Hnit3003/Intern_PIFLAB_2023/Solfware/build/bootloader-prefix/src/bootloader-stamp/bootloader-source_dirinfo.txt

# This is a generated file and its contents are an internal implementation detail.
# The download step will be re-executed if anything in this file changes.
# No other meaning or use of this file is supported.

method=source_dir
command=
source_dir=D:/Solfware/ESP_IDF/Espressif/frameworks/esp-idf-v4.4.4/components/bootloader/subproject
work_dir=
