Hnit3003/Intern_PIFLAB_2023/Hardware/Datasheet/Board thực tập hè.xlsx

Board thực tập hè 2023
Số thứ tự | Tên | Số lượng | Giá | Link sản phẩm | Datasheet
1 | Mạch Thu Phát Wifi BLE SoC ESP32 ESP-WROOM-32E | 1 | 95000 | Mạch thu phát Wifi BLE SoC ESP32 ESP-WROOM-32E chính hãng Espressif – Hshop.vn (https://hshop.vn/products/mach-thu-phat-wifi-ble-soc-esp32-v1) | esp32-wroom-32e_esp32-wroom-32ue_datasheet_en.pdf (espressif.com) (https://www.espressif.com/sites/default/files/documentation/esp32-wroom-32e_esp32-wroom-32ue_datasheet_en.pdf) | 95000
10 | LM2596S-5.0 IC Điều Chỉnh Giảm Áp 5V 3A TO-263-5 | 1 | 7900 | LM2596S-5.0 IC Điều Chỉnh Giảm Áp 5V 3A TO-263-5 Điện áp vào: 4.5-40VDC, điện áp ra: 5VDC, 1 ngõ ra (thegioiic.com) (https://www.thegioiic.com/lm2596s-5-0-ic-dieu-chinh-giam-ap-5v-3a-to-263-5) | LM2596 SIMPLE SWITCHER® Power Converter 150-kHz 3-A Step-Down Voltage Regulator datasheet (Rev. G) (ti.com) (https://www.ti.com/lit/ds/symlink/lm2596.pdf) | 7900
11 | CDRH127 Cuộn Cảm Dán SMD 1280-680 68uH 3.2A | 1 | 3200 | CDRH127 Cuộn Cảm Dán SMD 1280-680 68uH 3.2A 20%, size 12 x 12 x 8mm (thegioiic.com) (https://www.thegioiic.com/cdrh127-cuon-cam-dan-smd-1280-680-68uh-3-2a) |  | 3200
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
