Hnit3003/Intern_PIFLAB_2023/Hardware/Intership_board.kicad_pcb

## KiCad design Hardware/Intership_board.kicad_pcb (2023-08-09)

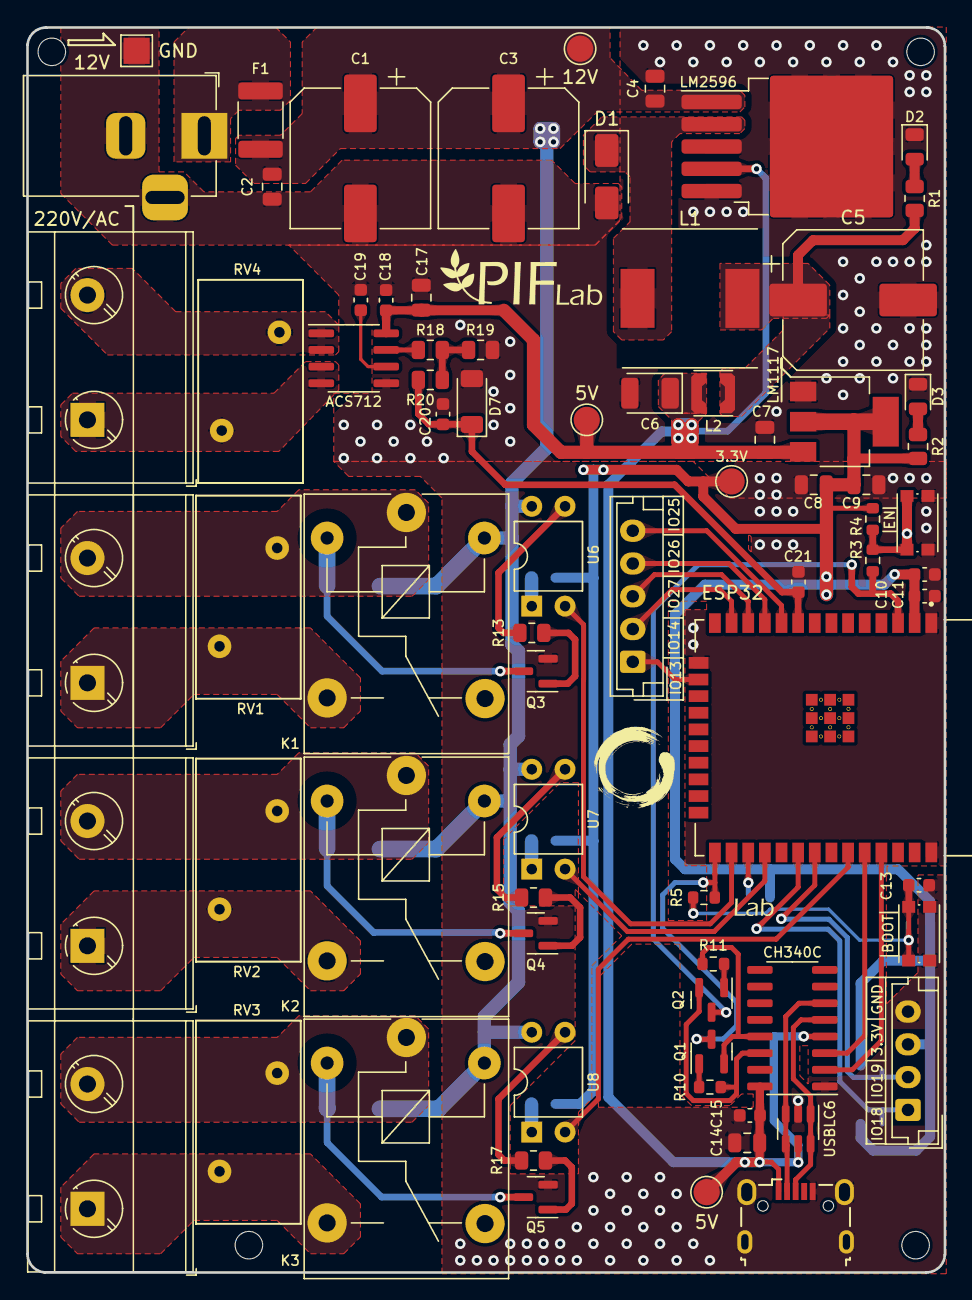
[picture p1: board Intership_board.kicad_pcb from above]

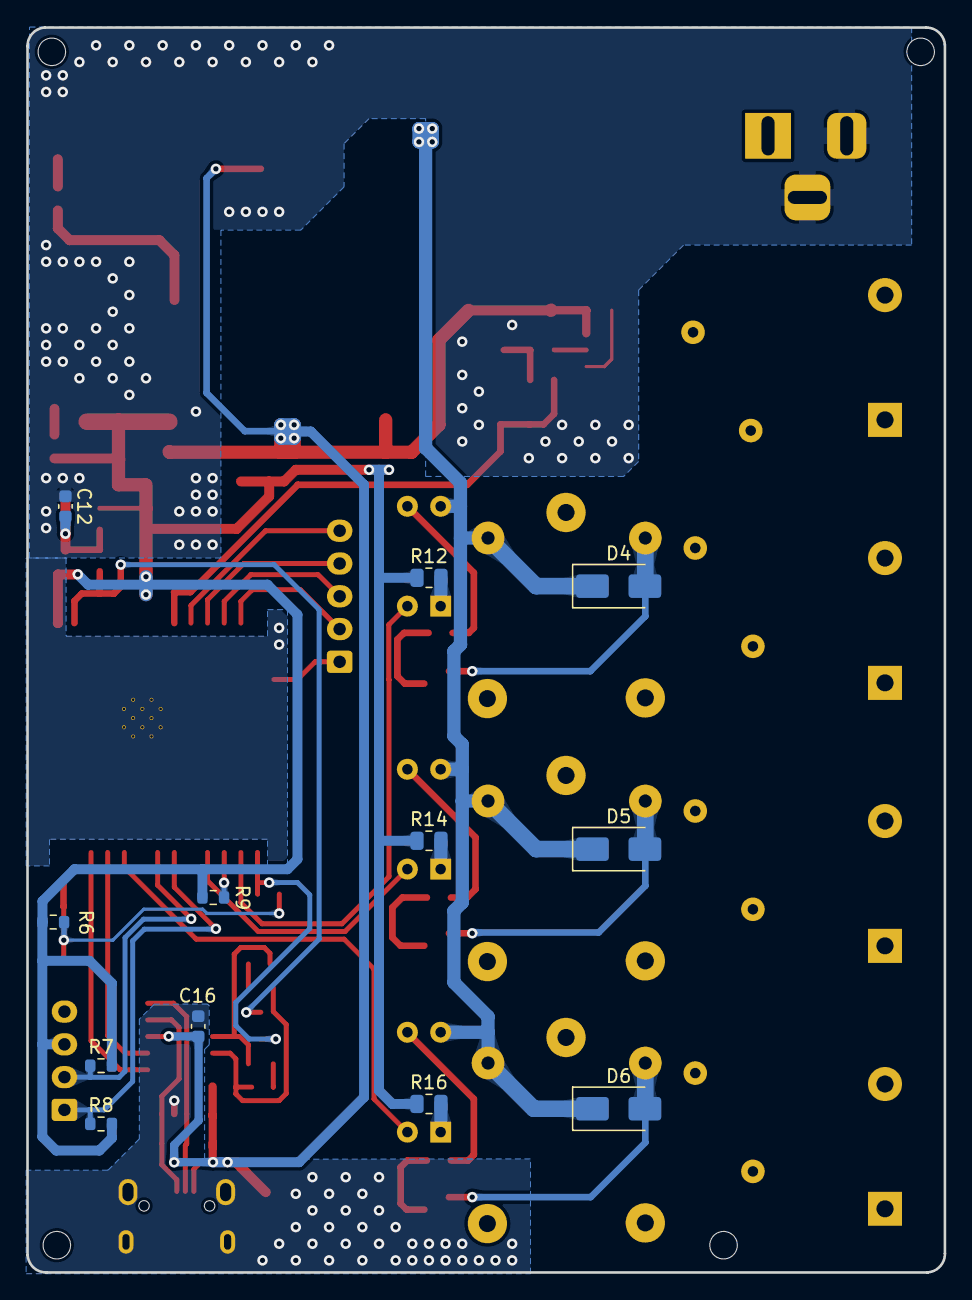
[picture p2: board Intership_board.kicad_pcb from below]

Board: 2 copper layers, 70.0 x 95.0 mm, 91 parts (12 on the bottom side), 56 nets.

Parts:
3.3V: 3.3VDC; TestPoint_Pad_D2.0mm
5V: USB_B_Mini; USB_Micro-B_Wuerth_629105150521
5V#2: VBUS; TestPoint_Pad_D2.0mm
5V#3: 5VDC; TestPoint_Pad_D2.0mm
12V: 12VDC/2~3mA; BarrelJack_Horizontal
12V#2: 12VDC; TestPoint_Pad_D2.0mm
220V/AC: Load 220V/AC; TerminalBlock_MetzConnect_Type703_RT10N02HGLU_1x02_P9.52mm_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
ACS712: ACS712xLCTR-20A; SOIC-8_3.9x4.9mm_P1.27mm
BOOT: SW_Push; SW_Push_1P1T_NO_CK_KMR2
C1, C3: 470uF/35V; CP_Elec_10x10.5
C2, C4: 0.1uF/50V; C_0805_2012Metric
C5: 330uF/35V; CP_Elec_10x10.5
C6: 220uF/16V; CP_EIA-3528-12_Kemet-T
C7, C14: 10uF/25V; C_0805_2012Metric
C8, C17: 22uF/16V; C_0805_2012Metric
C9: 100nF/50V; C_0805_2012Metric
C10: 10uF/25V; C_0603_1608Metric
C11, C12, C13, C15, C16, C18, C19, C21: 100nF/50V; C_0603_1608Metric
C20: 500nF/25V; C_0603_1608Metric
CH340C: CH340C; SOIC-16_3.9x9.9mm_P1.27mm
D1: SS34/3A; D_SMA
D2, D3: LED; LED_0805_2012Metric
D4, D5, D6: SS210/2A/100V; D_SMA
D7: ZMM3V3; D_MiniMELF
EN: SW_Push; SW_Push_1P1T_NO_CK_KMR2
ESP32: ESP32-WROOM-32E; XCVR_ESP32-WROOM-32E
F1: 500mA; Fuse_1812_4532Metric_Pad1.30x3.40mm_HandSolder
GND: Earth; TestPoint_Pad_2.0x2.0mm
H1, H3, H4: Through Hole; MountingHole_2.1mm
H2: Through hole; MountingHole_2.1mm
J2: Conn_01x04_Pin; JST_EH_B4B-EH-A_1x04_P2.50mm_Vertical
J3: Conn_01x05_Pin; JST_EH_B5B-EH-A_1x05_P2.50mm_Vertical
J5, J6, J7: Load 220V/AC; TerminalBlock_MetzConnect_Type703_RT10N02HGLU_1x02_P9.52mm_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
K1, K2, K3: SRD-12VDC-SL-C; Relay_SPDT_SANYOU_SRD_Series_Form_C
L1: 68uH/2.08A; L_Taiyo-Yuden_NR-10050_9.8x10.0mm
L2: 3uH/2.2A; L_Coilcraft_LPS3010
LM1117: LM1117MP-3.3; SOT-223-3_TabPin2
LM2596: LM2596S-ADJ; TO-263-5_TabPin3
Q1, Q2: BC817; SOT-23
Q3, Q4, Q5: MMBTA42/300V/0.5mA; SOT-23
R1, R2, R18, R19: 1k; R_0805_2012Metric
R3, R5: 0; R_0603_1608Metric
R4, R6, R7, R8, R9, R10, R11: 10k; R_0603_1608Metric
R12, R14, R16: 200; R_0805_2012Metric
R13, R15, R17: 2.2k; R_0805_2012Metric
R20: 2.1k; R_0805_2012Metric
RV1, RV2, RV3, RV4: 420L40/680V; RV_Disc_D15.5mm_W8mm_P7.5mm
U6, U7, U8: PC817; DIP-4_W7.62mm
USBLC6: USBLC6-2SC6; SOT-23-6

Connections:
3.3VDC: 3.3V.1, C8.1, C9.1, C10.1, C11.1, ESP32.2 (VDD), J2.3, LM1117.2 (VO), R2.1, R4.2, R6.2, R7.2, R8.2, R9.2, R12.1, R14.1, R16.1
5VDC: 5V.1 (VBUS), 5V#2.1, 5V#3.1, ACS712.8 (VCC), C6.1, C7.1, C14.2, C15.2, C16.1, C17.2, C18.2, CH340C.4 (V3), CH340C.16 (VCC), L2.2, LM1117.3 (VI), LM2596.4 (FB), USBLC6.5 (VBUS)
12VDC: 12V#2.1, C1.1, C2.1, C3.1, C4.1, D4.1 (K), D5.1 (K), D6.1 (K), F1.2, K1.5, K2.5, K3.5, LM2596.1 (VIN), U6.4, U7.4, U8.4
DTR: CH340C.13 (~DTR), Q1.2 (E), R11.1
ESP_EN: ESP32.3 (EN), Q2.3 (C), R3.2
ESP_IO0: ESP32.25 (IO0), Q1.3 (C), R5.1
ESP_IO18: ESP32.30 (IO18), J2.1, R8.1
ESP_IO19: ESP32.31 (IO19), J2.2, R7.1
ESP_IO25: ESP32.10 (IO25), J3.5
ESP_IO26: ESP32.11 (IO26), J3.4
ESP_IO27: ESP32.12 (IO27), J3.3
ESP_IO_ADC2_CH0: C20.2, C21.2, D7.1 (K), ESP32.9 (IO33), R20.2
ESP_IO_Relay_1: ESP32.26 (IO4), U6.2
ESP_IO_Relay_2: ESP32.28 (IO17), U7.2
ESP_IO_Relay_3: ESP32.33 (IO21), U8.2
ESP_MOSI: ESP32.16 (IO13), J3.1
ESP_RXD: CH340C.3 (RXD), ESP32.34 (RXD0/IO3)
ESP_SCLK: ESP32.13 (IO14), J3.2
ESP_TXD: CH340C.2 (TXD), ESP32.35 (TXD0/IO1)
Earth: 5V.5 (GND), 5V.6 (Shield), 12V.2, 12V.3, ACS712.5 (GND), BOOT.2, C1.2, C2.2, C3.2, C4.2, C5.2, C6.2, C7.2, C8.2, C9.2, C10.2, C11.2, C12.1, C13.2, C14.1, C15.1, C16.2, C17.1, C18.1, C19.1, C20.1, C21.1, CH340C.1 (GND), D1.2 (A), D2.1 (K), D3.1 (K), D7.2 (A), EN.1, ESP32.1 (GND), ESP32.15 (GND), ESP32.38 (GND), ESP32.39_10, ESP32.39_11, ESP32.39_12, ESP32.39_13, ESP32.39_14, ESP32.39_15, ESP32.39_16, ESP32.39_17, ESP32.39_18, ESP32.39_19, ESP32.39_20, ESP32.39_21, GND.1, J2.4, LM1117.1 (GND), LM2596.3 (GND), LM2596.5 (~ON/OFF), Q3.2 (E), Q4.2 (E), Q5.2 (E), R19.1, USBLC6.2 (GND)
unnamed: C5.1, L1.2, L2.1, R1.1
unnamed: C12.2, EN.2, R3.1, R4.1
unnamed: BOOT.1, C13.1, R5.2, R6.1
unnamed: D1.1 (K), L1.1, LM2596.2 (OUT)
unnamed: D2.2 (A), R1.2
unnamed: D3.2 (A), R2.2
unnamed: D4.2 (A), K1.2, Q3.3 (C)
unnamed: D5.2 (A), K2.2, Q4.3 (C)
unnamed: D6.2 (A), K3.2, Q5.3 (C)
unnamed: 12V.1, F1.1
unnamed: 5V.3 (D+), CH340C.5 (UD+), USBLC6.1 (I/O1), USBLC6.6 (I/O1)
unnamed: 5V.2 (D-), CH340C.6 (UD-), USBLC6.3 (I/O2), USBLC6.4 (I/O2)
unnamed: J5.1, K1.3, RV1.1
unnamed: J5.2, K1.1, RV1.2
unnamed: J6.1, K2.3, RV2.1
unnamed: J6.2, K2.1, RV2.2
unnamed: J7.1, K3.3, RV3.1
unnamed: J7.2, K3.1, RV3.2
unnamed: 220V/AC.1, ACS712.3 (IP-), ACS712.4 (IP-), RV4.2
unnamed: 220V/AC.2, ACS712.1 (IP+), ACS712.2 (IP+), RV4.1
unnamed: Q1.1 (B), R10.2
unnamed: Q2.1 (B), R11.2
unnamed: Q3.1 (B), R13.2
unnamed: Q4.1 (B), R15.2
unnamed: Q5.1 (B), R17.2
unnamed: R12.2, U6.1
unnamed: R13.1, U6.3
unnamed: R14.2, U7.1
unnamed: R15.1, U7.3
unnamed: R16.2, U8.1
unnamed: R17.1, U8.3
unnamed: R18.2, R19.2, R20.1
unnamed: ESP32.27 (IO16), R9.1
unnamed: ACS712.6 (FILTER), C19.2
unnamed: ACS712.7 (VIOUT), R18.1
RTS: CH340C.14 (~RTS), Q2.2 (E), R10.1
